SDSURocketProject/thermocouple-board/docs/thermocouple-board.pdf

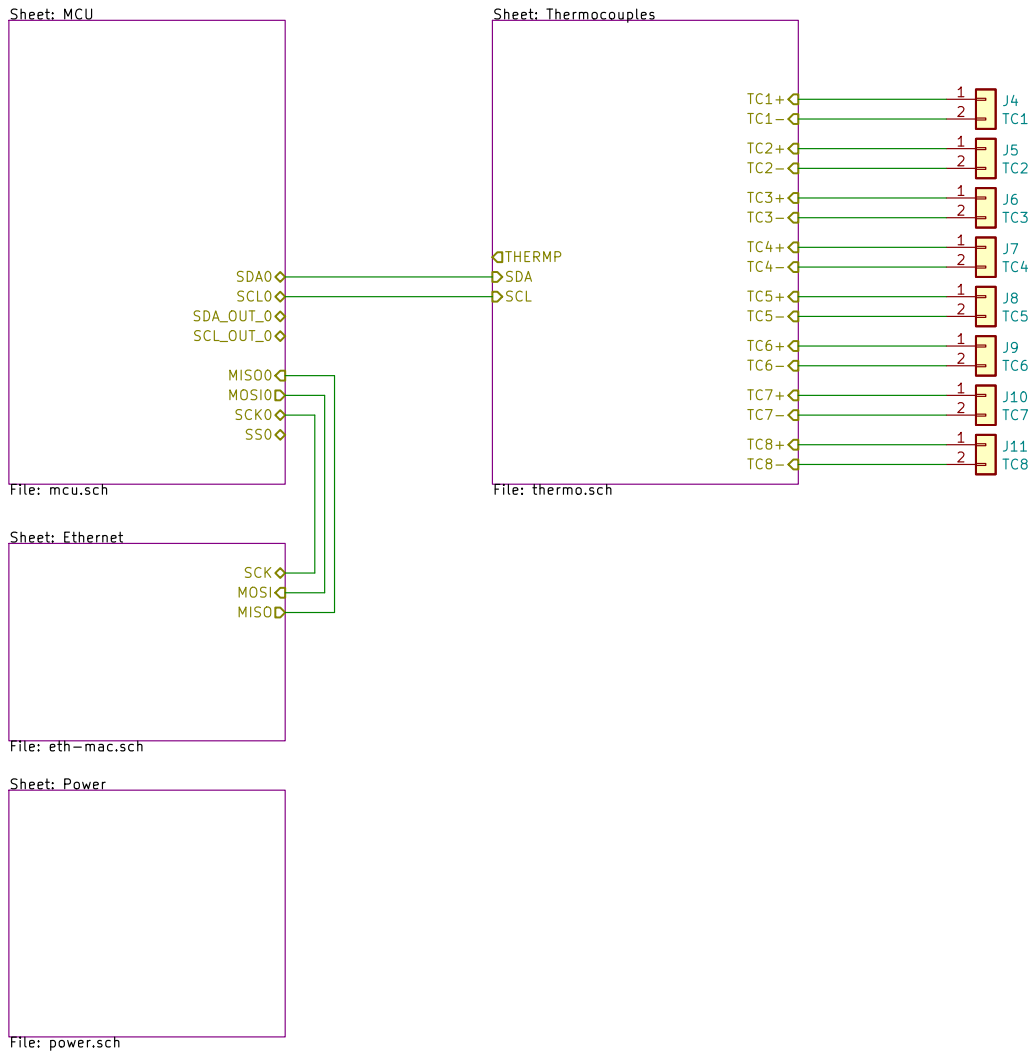
[picture p1: page 1]

Sheet: Thermocouples File: thermo.sch THERMP

Sheet: Power File: power.sch

File: thermocouple-board.sch Sheet: / SDSU Rocket Project

Id: 1/5 Title: Module Control Board

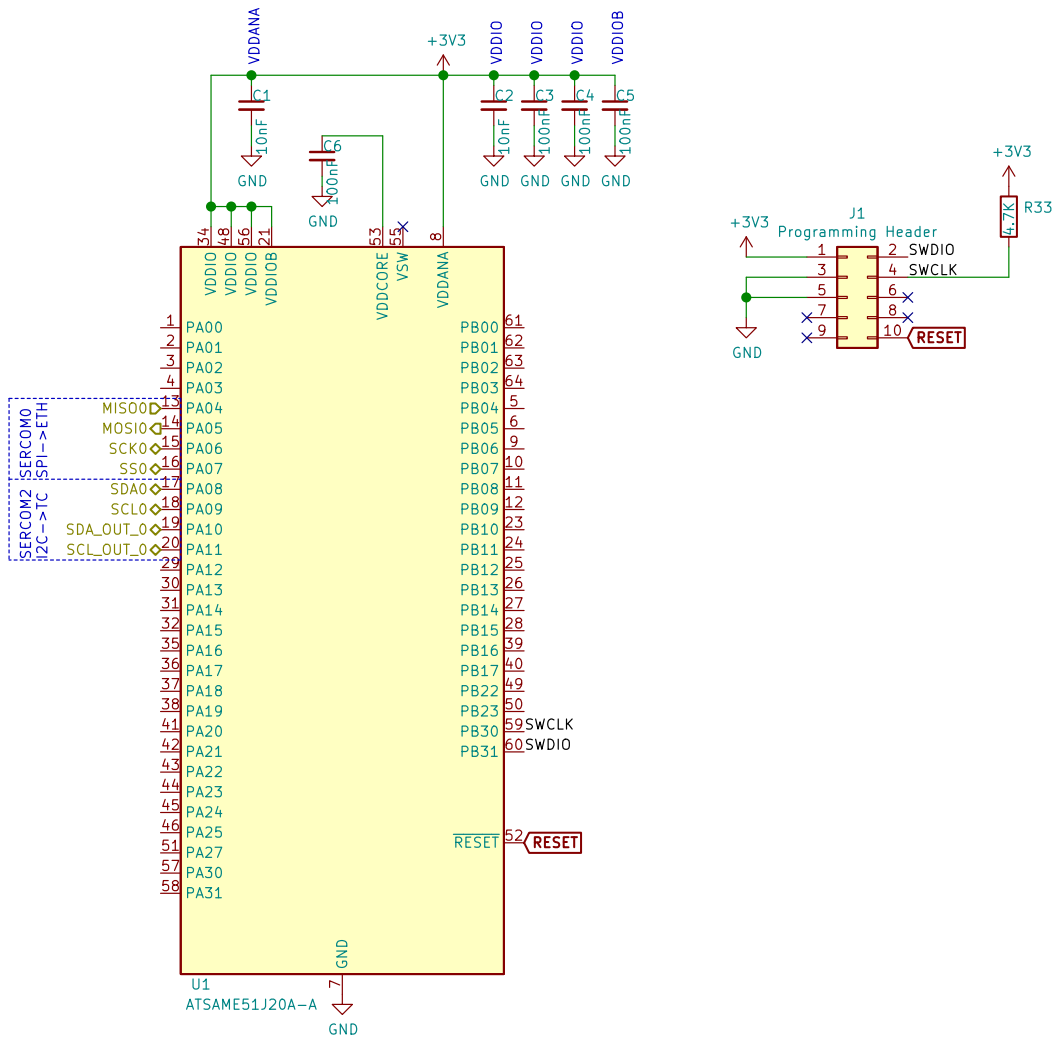
[picture p2: page 2]

Discovery MCU/Ethernet GND

File: mcu.sch Sheet: /MCU/ SDSU Rocket Project

Id: 2/5 Title: Module Control Board

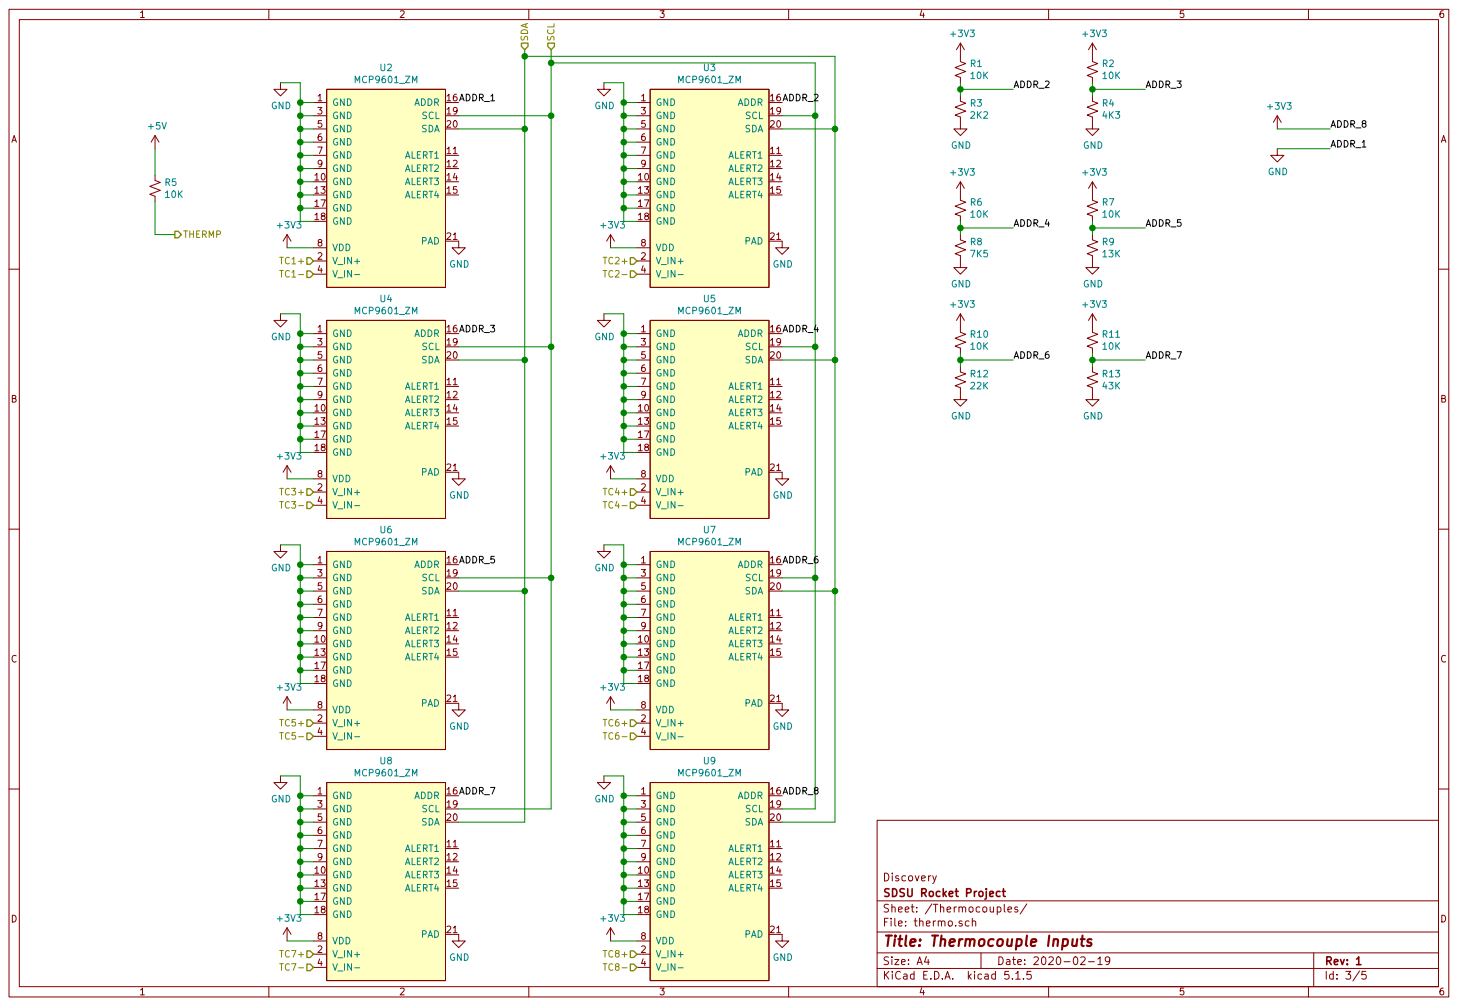
[picture p3: page 3]

Discovery
SDSU Rocket Project
File: thermo.sch Sheet: /Thermocouples/
Id: 3/5 Title: Thermocouple Inputs

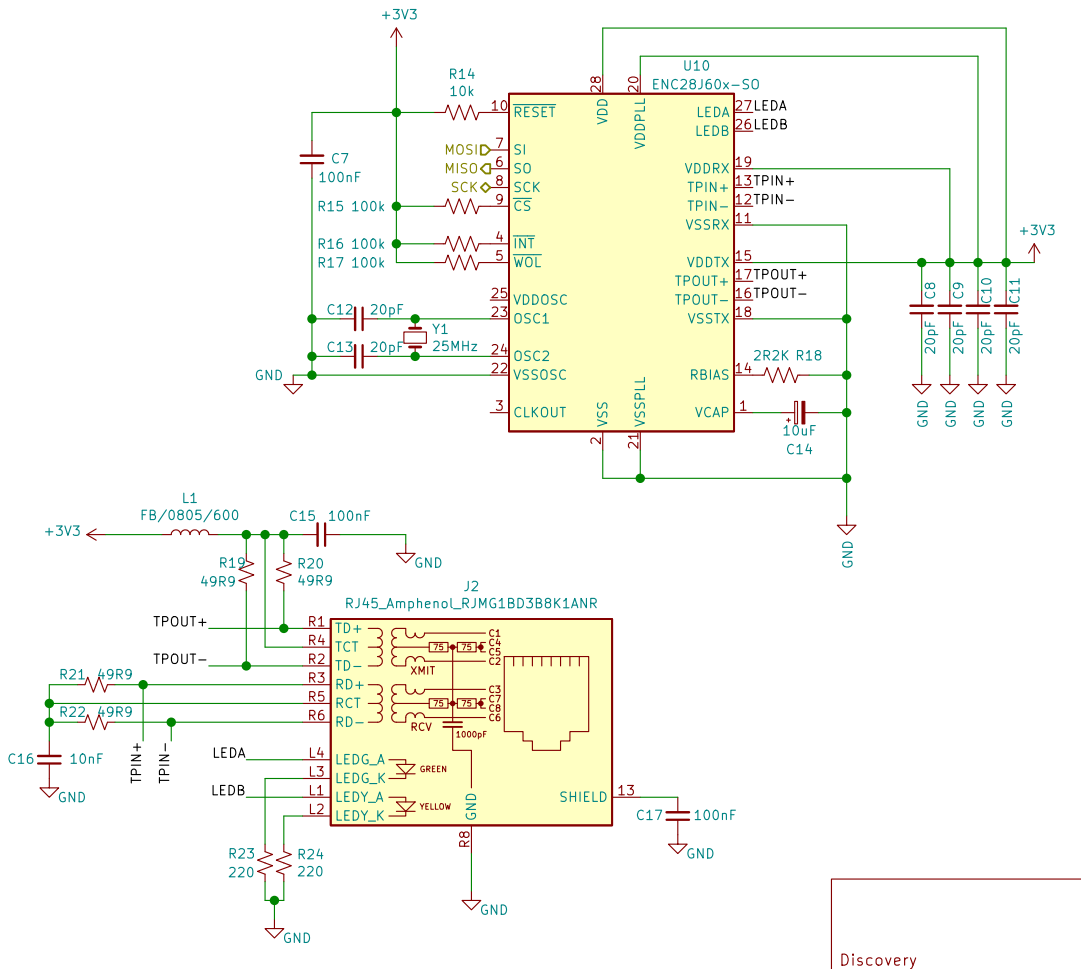
[picture p4: page 4]

TPIN+ TPIN- TPOUT+ TPOUT- TPOUT+ TPOUT-

File: eth-mac.sch Sheet: /Ethernet/ SDSU Rocket Project

Id: 4/5 Title: Ethernet PHY+MAC Interface

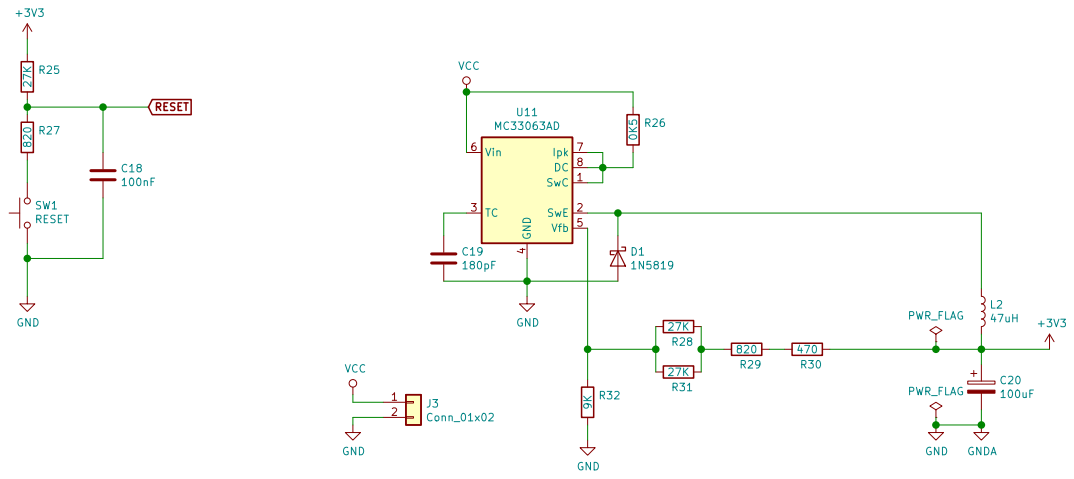
[picture p5: page 5]

Discovery
File: power.sch Sheet: /Power/ SDSU Rocket Project

Id: 5/5 Title: Power Management
