SDSURocketProject/thermocouple-board/docs/mcb-schematic.pdf

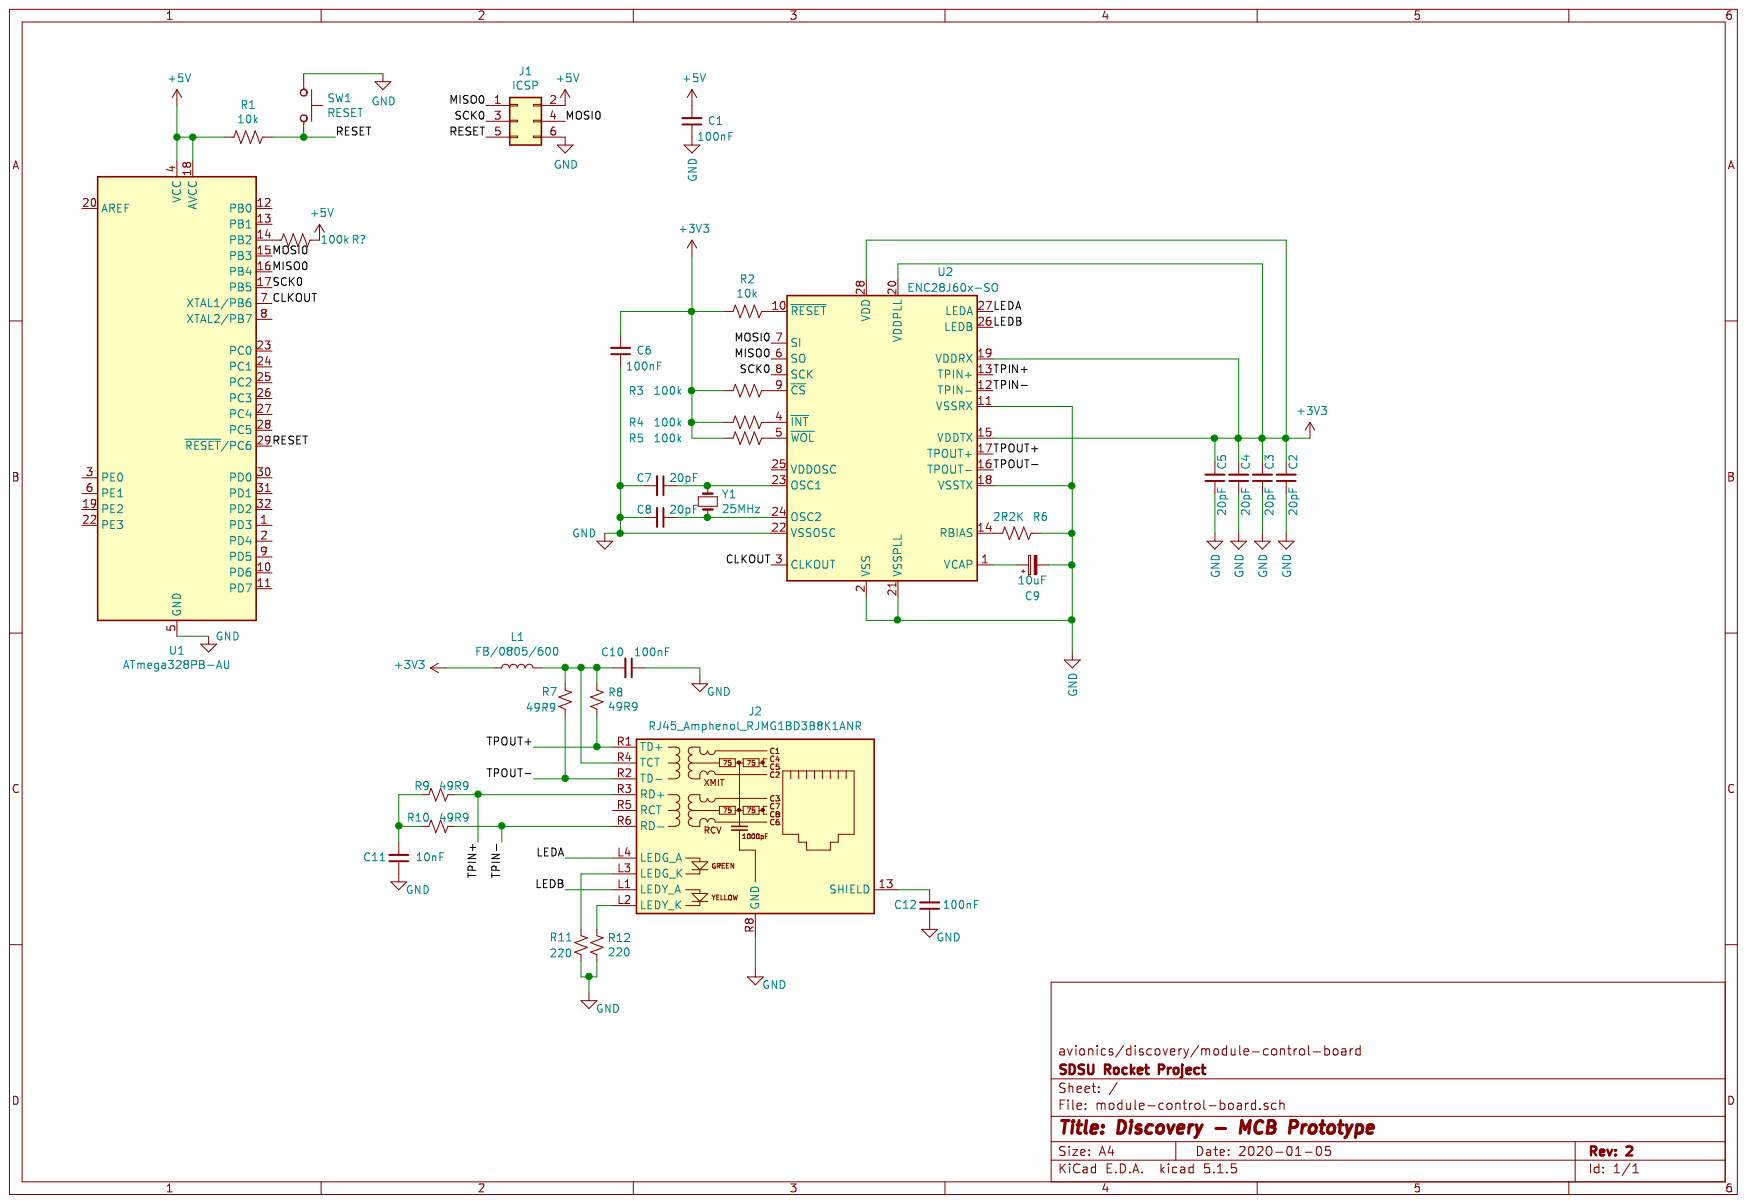
[picture p6: page 1]
