SDSURocketProject/thermocouple-board/thermocouple-board.kicad_pcb

## KiCad design thermocouple-board.kicad_pcb (2020-02-22)

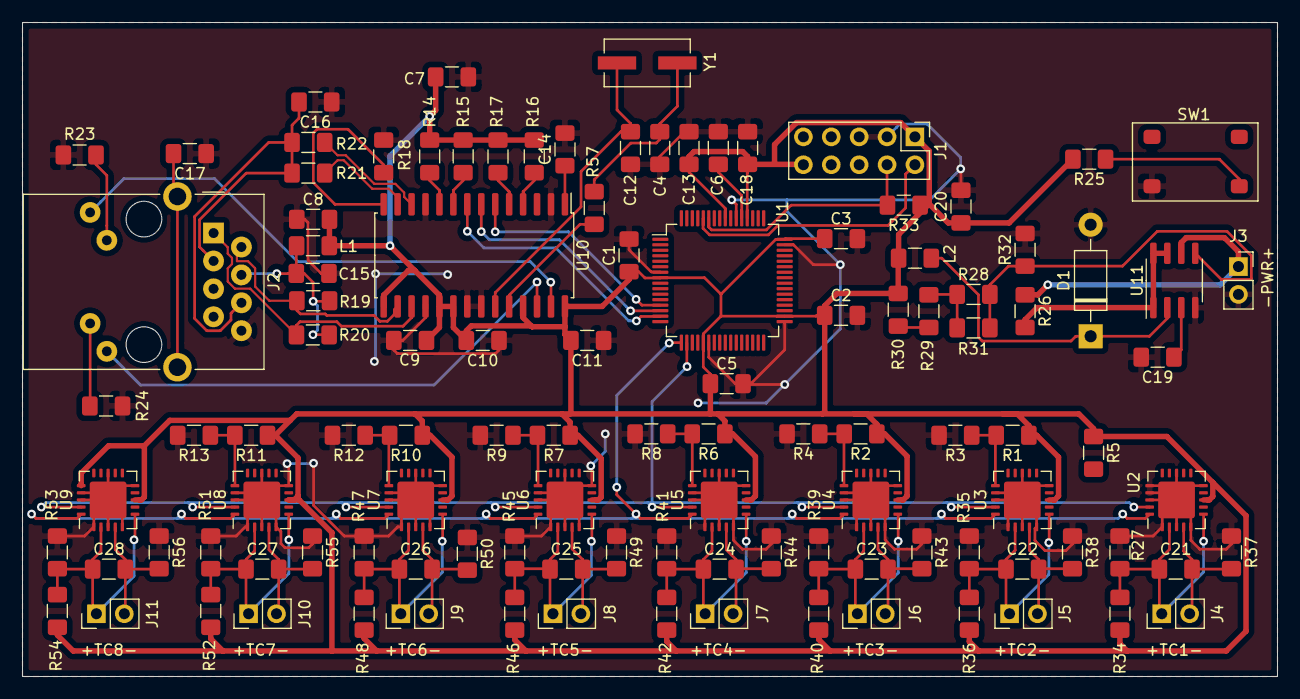
[picture p7: board thermocouple-board.kicad_pcb from above]

Board: 2 copper layers, 114.3 x 59.6 mm, 113 parts (1 on the bottom side), 60 nets.

Parts:
C1, C2, C16: 10nF; C_1206_3216Metric_Pad1.42x1.75mm_HandSolder
C3, C4, C5, C6, C7, C15, C17, C18: 100nF; C_1206_3216Metric_Pad1.42x1.75mm_HandSolder
C8, C9, C10, C11, C12, C13: 20pF; C_1206_3216Metric_Pad1.42x1.75mm_HandSolder
C14: 10uF; C_1206_3216Metric_Pad1.42x1.75mm_HandSolder
C19: 180pF; C_1206_3216Metric_Pad1.42x1.75mm_HandSolder
C20: 100uF; C_1206_3216Metric_Pad1.42x1.75mm_HandSolder
C21, C22, C23, C24, C25, C26, C27, C28: 0.1uF; C_1206_3216Metric_Pad1.42x1.75mm_HandSolder
D1: 1N5819; D_DO-41_SOD81_P10.16mm_Horizontal
J1: Programming Header; PinHeader_2x05_P2.54mm_Vertical
J2: RJ45_Amphenol_RJMG1BD3B8K1ANR
J3: Conn_01x02; PinSocket_1x02_P2.54mm_Vertical
J4: TC1; PinHeader_1x02_P2.54mm_Vertical
J5: TC2; PinHeader_1x02_P2.54mm_Vertical
J6: TC3; PinHeader_1x02_P2.54mm_Vertical
J7: TC4; PinHeader_1x02_P2.54mm_Vertical
J8: TC5; PinHeader_1x02_P2.54mm_Vertical
J9: TC6; PinHeader_1x02_P2.54mm_Vertical
J10: TC7; PinHeader_1x02_P2.54mm_Vertical
J11: TC8; PinHeader_1x02_P2.54mm_Vertical
L1: FB/0805/600; L_1206_3216Metric_Pad1.42x1.75mm_HandSolder
L2: 47uH; L_1206_3216Metric_Pad1.42x1.75mm_HandSolder
QR*****: ID_QR_TC_PROTO_FEB_2020
R1, R2, R5, R6, R7, R10, R11, R32: 10K; R_1206_3216Metric_Pad1.42x1.75mm_HandSolder
R3: 2K2; R_1206_3216Metric_Pad1.42x1.75mm_HandSolder
R4: 4K3; R_1206_3216Metric_Pad1.42x1.75mm_HandSolder
R8: 7K5; R_1206_3216Metric_Pad1.42x1.75mm_HandSolder
R9: 13K; R_1206_3216Metric_Pad1.42x1.75mm_HandSolder
R12: 22K; R_1206_3216Metric_Pad1.42x1.75mm_HandSolder
R13: 43K; R_1206_3216Metric_Pad1.42x1.75mm_HandSolder
R14: 10k; R_1206_3216Metric_Pad1.42x1.75mm_HandSolder
R15, R16, R17: 100k; R_1206_3216Metric_Pad1.42x1.75mm_HandSolder
R18: 2R2K; R_1206_3216Metric_Pad1.42x1.75mm_HandSolder
R19, R20, R21, R22: 49R9; R_1206_3216Metric_Pad1.42x1.75mm_HandSolder
R23, R24: 220; R_1206_3216Metric_Pad1.42x1.75mm_HandSolder
R25: 330; R_1206_3216Metric_Pad1.42x1.75mm_HandSolder
R26: 0K5; R_1206_3216Metric_Pad1.42x1.75mm_HandSolder
R27, R35, R37, R38, R39, R41, R43, R44, R45, R47, R49, R50, R51, R53, R55, R56: 2M; R_1206_3216Metric_Pad1.42x1.75mm_HandSolder
R28, R31: 27K; R_1206_3216Metric_Pad1.42x1.75mm_HandSolder
R29: 820; R_1206_3216Metric_Pad1.42x1.75mm_HandSolder
R30: 470; R_1206_3216Metric_Pad1.42x1.75mm_HandSolder
R33: 1K; R_1206_3216Metric_Pad1.42x1.75mm_HandSolder
R34, R36, R40, R42, R46, R48, R52, R54: 1M; R_1206_3216Metric_Pad1.42x1.75mm_HandSolder
R57: 5M; R_1206_3216Metric_Pad1.42x1.75mm_HandSolder
SW1: RESET; omron-b3s
U1: ATSAME51J20A-A; TQFP-64_10x10mm_P0.5mm
U2, U3, U4, U5, U6, U7, U8, U9: MCP9601_ZM; QFN-20-1EP_5x5mm_P0.65mm_EP3.35x3.35mm
U10: ENC28J60x-SO; SOIC-28W_7.5x17.9mm_P1.27mm
U11: MC33063AD; SOIC-8_3.9x4.9mm_P1.27mm
Y1: 25MHz; Crystal_SMD_ECS_CSM3X-2Pin_7.6x4.1mm

Connections:
+3V3: C1.1, C2.1, C3.1, C4.1, C5.1, C7.2, C8.2, C9.2, C10.2, C11.2, C18.1, C20.1, J1.1, J1.10, L1.1, L2.2, R1.1, R2.1, R5.1, R6.1, R7.1, R10.1, R11.1, R14.2, R15.2, R16.2, R17.2, R25.2, R30.1, R33.1, R34.2, R36.2, R40.2, R42.2, R46.2, R48.2, R52.2, R54.2, U1.8, U1.21, U1.34, U1.48, U1.52, U1.56, U2.8, U3.8, U4.8, U5.8, U6.8, U7.8, U8.8, U9.8, U9.16, U10.15, U10.19, U10.20, U10.25, U10.28
/Ethernet/LEDA: J2.L4, U10.27
/Ethernet/LEDB: J2.L1, U10.26
/Ethernet/MISO: U1.13, U10.6
/Ethernet/MOSI: U1.14, U10.7
/Ethernet/SCK: U1.15, U10.8
/Ethernet/TPIN+: R21.1, U10.13
/Ethernet/TPIN-: R22.1, U10.12
/Ethernet/TPOUT+: J2.R1, R20.2, U10.17
/Ethernet/TPOUT-: J2.R2, R19.2, U10.16
/MCU/SWCLK: J1.4, R33.2, U1.59
/MCU/SWDIO: J1.2, U1.60
/Thermocouples/ADDR_2: R1.2, R3.1, U3.16
/Thermocouples/ADDR_3: R2.2, R4.1, U4.16
/Thermocouples/ADDR_4: R6.2, R8.1, U5.16
/Thermocouples/ADDR_5: R7.2, R9.1, U6.16
/Thermocouples/ADDR_6: R10.2, R12.1, U7.16
/Thermocouples/ADDR_7: R11.2, R13.1, U8.16
/Thermocouples/SCL: U1.18, U2.19, U3.19, U4.19, U5.19, U6.19, U7.19, U8.19, U9.19
/Thermocouples/SDA: U1.17, U2.20, U3.20, U4.20, U5.20, U6.20, U7.20, U8.20, U9.20
/Thermocouples/TC1+: C21.1, J4.1, R27.2, R34.1, U2.2, U2.6
/Thermocouples/TC1-: C21.2, J4.2, R37.2, U2.4
/Thermocouples/TC2+: C22.1, J5.1, R35.2, R36.1, U3.2, U3.6
/Thermocouples/TC2-: C22.2, J5.2, R38.2, U3.4
/Thermocouples/TC3+: C23.1, J6.1, R39.2, R40.1, U4.2, U4.6
/Thermocouples/TC3-: C23.2, J6.2, R43.2, U4.4
/Thermocouples/TC4+: C24.1, J7.1, R41.2, R42.1, U5.2, U5.6
/Thermocouples/TC4-: C24.2, J7.2, R44.2, U5.4
/Thermocouples/TC5+: C25.1, J8.1, R45.2, R46.1, U6.2, U6.6
/Thermocouples/TC5-: C25.2, J8.2, R49.2, U6.4
/Thermocouples/TC6+: C26.1, J9.1, R47.2, R48.1, U7.2, U7.6
/Thermocouples/TC6-: C26.2, J9.2, R50.2, U7.4
/Thermocouples/TC7+: C27.1, J10.1, R51.2, R52.1, U8.2, U8.6
/Thermocouples/TC7-: C27.2, J10.2, R55.2, U8.4
/Thermocouples/TC8+: C28.1, J11.1, R53.2, R54.1, U9.2, U9.6
/Thermocouples/TC8-: C28.2, J11.2, R56.2, U9.4
GND: C1.2, C2.2, C3.2, C4.2, C5.2, C6.2, C7.1, C8.1, C9.1, C10.1, C11.1, C12.2, C13.2, C14.2, C15.1, C16.1, C17.1, C18.2, C19.2, C20.2, D1.2, J1.3, J1.5, J2.R8, J3.2, R3.2, R4.2, R8.2, R9.2, R12.2, R13.2, R18.2, R23.2, R24.2, R27.1, R32.2, R35.1, R37.1, R38.1, R39.1, R41.1, R43.1, R44.1, R45.1, R47.1, R49.1, R50.1, R51.1, R53.1, R55.1, R56.1, SW1.2, U1.7, U1.22, U1.33, U1.47, U1.54, U2.1, U2.3, U2.5, U2.10, U2.13, U2.16, U2.17, U2.18, U2.21, U3.1, U3.3, U3.5, U3.10, U3.13, U3.17, U3.18, U3.21, U4.1, U4.3, U4.5, U4.10, U4.13, U4.17, U4.18, U4.21, U5.1, U5.3, U5.5, U5.10, U5.13, U5.17, U5.18, U5.21, U6.1, U6.3, U6.5, U6.10, U6.13, U6.17, U6.18, U6.21, U7.1, U7.3, U7.5, U7.10, U7.13, U7.17, U7.18, U7.21, U8.1, U8.3, U8.5, U8.10, U8.13, U8.17, U8.18, U8.21, U9.1, U9.3, U9.5, U9.10, U9.13, U9.17, U9.18, U9.21, U10.2, U10.11, U10.18, U10.21, U10.22, U11.4
unnamed: C6.1, U1.53
unnamed: C12.1, U10.23, Y1.1
unnamed: C13.1, R57.2, Y1.2
unnamed: C14.1, U10.1
unnamed: C15.2, J2.R4, L1.2, R19.1, R20.1
unnamed: C16.2, J2.R3, J2.R6, R21.2, R22.2
unnamed: C17.2, J2.13
unnamed: C19.1, U11.3
unnamed: D1.1, L2.1, U11.2
unnamed: J2.L2, R24.1
unnamed: J2.L3, R23.1
unnamed: R14.1, U10.10
unnamed: R15.1, U10.9
unnamed: R16.1, U10.4
unnamed: R17.1, U10.5
unnamed: R18.1, U10.14
unnamed: R25.1, SW1.1
unnamed: R26.2, U11.1, U11.7, U11.8
unnamed: R28.1, R29.2, R31.1
unnamed: R28.2, R31.2, R32.1, U11.5
unnamed: R29.1, R30.2
unnamed: R57.1, U10.24
VCC: J3.1, R26.1, U11.6
