SDSURocketProject/thermocouple-board/(commit log)

2020-01-02 Add empty KiCad project
    [module-control-board.kicad_pcb, module-control-board.sch]
2020-01-02 Add datasheets for currently used ICs
    - MCP9600 Thermocouple Conditioning IC
    - ATMEGA328PB 8-bit Microcontroller
    - ENC28J60 - PHY/MAC Ethernet Controller
2020-01-06 Add first attempt at MCU and MAC/PHY schematics
    MCU is standard ATMEAG328PB with SPI connection to the ENC28J60 Ethernet
    PHY/MAC controller and an ICSP header for programming. The ATMEGA328PB
    was chosen because it is a familiar platform for Arduino users, with
    additional serial interfaces to what the ATMEGA328P has.
    Wiring of the ENC28J60 is based on the schematic of the MOD-ENC28J60
    Ethernet Development Board from Olimex.
    The Amphenol RJMG1BD3B8K1ANR 8P8C RJ45 Connector was chosen because it
    is a part of the default KiCad library and includes the center-taped
    pulse transformers required by the ENC28J60.
    Makes progress towards DS-9
    [module-control-board.sch]
2020-01-06 Revise schematic based on sanity check from David
    - Replace global net labels with local net labels
    - Add missing SPI net labels to U2
    - Reorient GND ports to face down and +5V/+3V3 ports to face up
    - Properly ground shield pin on J2
    [module-control-board.sch]
2020-02-16 Add prototype thermocouple schematic
    [mcu-eth.sch, module-control-board.sch, pressuretd.sch, thermo.sch]
2020-02-17 Replace MCU with more effective alternative
    The ATMEGA328PB raised concerns about its ability to process input data
    at an acceptable speed, and so it has beed replaced with the
    ATSAME51J20A, the same MCU used in the Helix expansion boards. This will
    also increase cross-compatibility with components and will decrease the
    number of unique components used in Avionics.
    [eth-mac.sch, mcu.sch, module-control-board.sch, power.sch, pressuretd.sch, thermo.sch]
2020-02-18 Rename to thermocouple-board
    [thermocouple-board.sch]
2020-02-18 Add footprints and create PCB file
    [eth-mac.sch, mcu.sch, power.sch, tc-board.sch, thermo.sch, thermocouple-board.kicad_pcb]
2020-02-20 Begin PCB placement and routing
    [thermo.sch, thermocouple-board.kicad_pcb, thermocouple-board.sch]
2020-02-20 Add PDF schematics
    [eth-mac.sch, mcu.sch, module-control-board.kicad_pcb, power.sch, thermo.sch, thermocouple-board.kicad_pcb, thermocouple-board.sch]
2020-02-22 Update schematic for MCP9601 circuit alerts
    Added the required circuitry to support the Open-circuit and
    Short-circuit detection functionality of the MCP9601, as per figure 1-1
    in the datasheet.
    [eth-mac.sch, mcu.sch, power.sch, thermo.sch]
2020-02-22 Preliminary replacement of components for MCP9601
    Following the changes in the previous commit, all components have been
    replaced in a bid for more space efficiency to reduce costs.
    No traces have been laid at this point.
    [thermocouple-board.kicad_pcb]
2020-02-22 Complete routing for PCB traces
    [thermocouple-board.kicad_pcb]
2020-02-22 Replace capacitor footprints with 1206
    [eth-mac.sch, mcu.sch, power.sch, thermo.sch, thermocouple-board.kicad_pcb]
